GeekOmar256/SmartSplint/docs/flowcharts/block_diagram.png

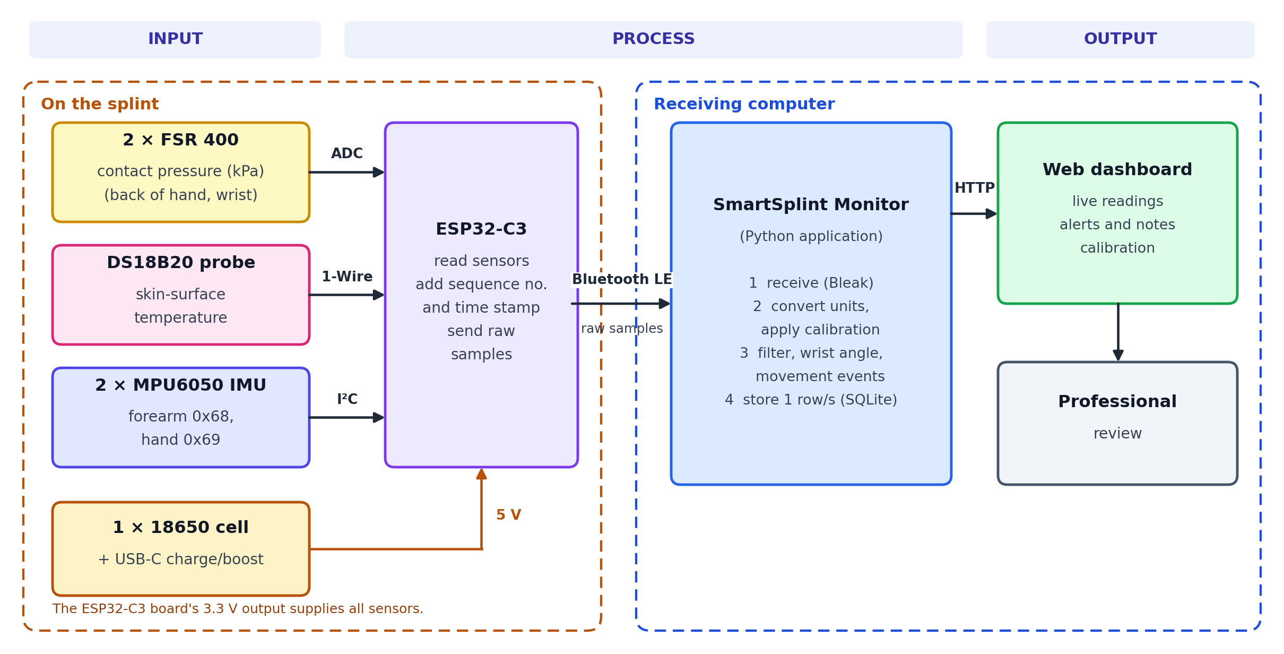
docs/flowcharts/block_diagram.png
