GeekOmar256/SmartSplint/docs/SmartSplint System Architecture.png

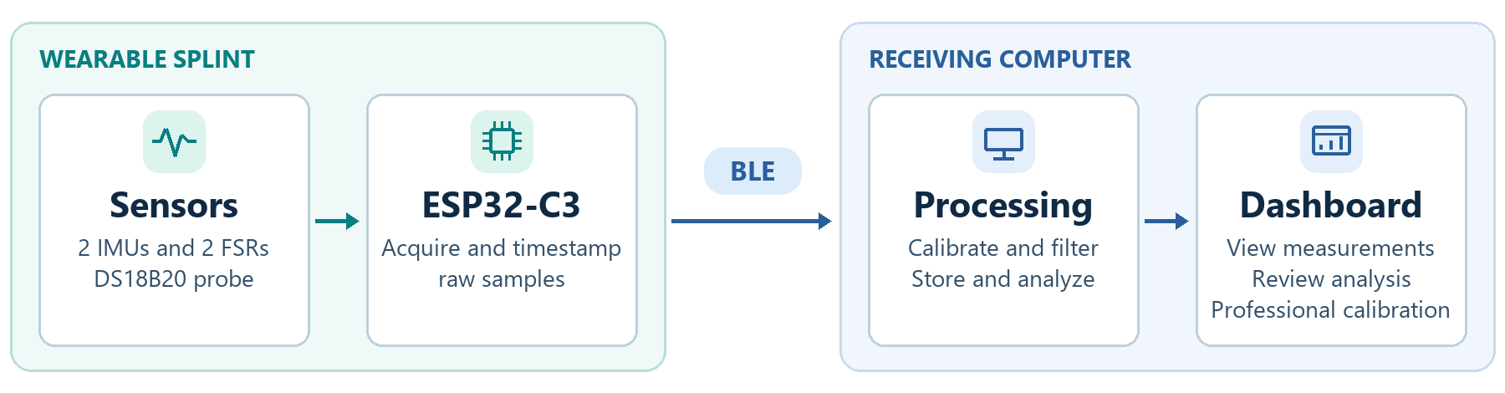
docs/SmartSplint System Architecture.png
