GeekOmar256/SmartSplint/SETUP_COMMANDS.txt

==========================================================================================
 Smart Orthopedic Splint - تثبيت البرنامج على كمبيوتر جديد (Windows 10 / 11)
==========================================================================================
 نفّذ الأوامر بالترتيب في PowerShell.
 (افتح قائمة Start، اكتب PowerShell، ثم اضغط Enter)
 انسخ كل أمر كما هو، ثم اضغط Enter بعده.

------------------------------------------------------------------------------------------
 الخطوة 1: تثبيت Python 3.12 (مع إضافته إلى الـ PATH)
------------------------------------------------------------------------------------------
winget install --id Python.Python.3.12 -e --override "/quiet InstallAllUsers=0 PrependPath=1 Include_launcher=1"

------------------------------------------------------------------------------------------
 الخطوة 2: تثبيت Git
------------------------------------------------------------------------------------------
winget install --id Git.Git -e

------------------------------------------------------------------------------------------
 الخطوة 3: أغلق نافذة PowerShell وافتح نافذة جديدة
------------------------------------------------------------------------------------------
 هذا ضروري حتى تتعرف النافذة الجديدة على python وgit.
 للتأكد من التثبيت، كل أمر من الأمرين التاليين يجب أن يطبع رقم إصدار:

python --version
git --version

------------------------------------------------------------------------------------------
 الخطوة 4: تنزيل الكود من GitHub
------------------------------------------------------------------------------------------
 المستودع عام (public)، لذلك لا يحتاج تسجيل دخول.

cd $HOME\Documents
git clone https://github.com/GeekOmar256/SmartSplint.git
cd SmartSplint

------------------------------------------------------------------------------------------
 الخطوة 5: تثبيت المكتبات
------------------------------------------------------------------------------------------
python -m pip install --upgrade pip
python -m pip install -r requirements.txt

 (اختياري) لإعادة رسم المخططات (flowcharts) ومخطط التوصيل:
python -m pip install -r requirements-docs.txt

------------------------------------------------------------------------------------------
 الخطوة 6: تشغيل التطبيق
------------------------------------------------------------------------------------------
 للتجربة بدون الجبيرة (بيانات محاكاة):
cd SmartSplint_Monitor
python server.py --simulate --demo-days 3

 مع الجبيرة الحقيقية (Bluetooth هو الاتصال الافتراضي):
python server.py

 تفتح الـ dashboard تلقائيًا على http://localhost:8000
 لإيقاف التطبيق اضغط Ctrl + C.
 يمكن أيضًا التشغيل بالضغط مرتين على run.bat أو run_simulation.bat داخل المجلد SmartSplint_Monitor.
 ملاحظة: شغّل Bluetooth في الكمبيوتر من Settings ثم Bluetooth & devices.

------------------------------------------------------------------------------------------
 الخطوة 7 (لرفع الكود على الـ ESP32): تثبيت Arduino IDE
------------------------------------------------------------------------------------------
winget install --id ArduinoSA.IDE.stable -e

 ثم داخل Arduino IDE:
   1) File > Preferences > Additional boards manager URLs، والصق هذا الرابط:
      https://espressif.github.io/arduino-esp32/package_esp32_index.json
   2) Tools > Board > Boards Manager: ابحث عن esp32 (by Espressif) وثبّت الإصدار 2.0.17
   3) Tools > Manage Libraries: ثبّت OneWire ثم DallasTemperature
   4) افتح الملف firmware\SmartSplint_Monitor_BLEOnly\SmartSplint_Monitor_BLEOnly.ino
   5) الإعدادات:
        Board            : ESP32C3 Dev Module
        USB CDC On Boot  : Enabled
        Partition Scheme : Default
   6) اختر الـ Port، ثم اضغط Upload

------------------------------------------------------------------------------------------
 (بديل للخطوة 7) رفع الكود باستخدام سطر الأوامر arduino-cli
------------------------------------------------------------------------------------------
winget install --id ArduinoSA.CLI -e
 (أغلق PowerShell وافتح نافذة جديدة، ثم ادخل مجلد SmartSplint مرة أخرى)
arduino-cli config init
arduino-cli config add board_manager.additional_urls https://espressif.github.io/arduino-esp32/package_esp32_index.json
arduino-cli core update-index
arduino-cli core install esp32:esp32@2.0.17
arduino-cli lib install OneWire DallasTemperature
arduino-cli board list
 (اكتب رقم الـ Port الظاهر، مثل COM5، بدل COM5 في الأمر التالي)
arduino-cli compile --upload -p COM5 --fqbn "esp32:esp32:esp32c3:CDCOnBoot=cdc" firmware\SmartSplint_Monitor_BLEOnly

------------------------------------------------------------------------------------------
 تحديث الكود لاحقًا (بعد أي تعديل جديد على GitHub)
------------------------------------------------------------------------------------------
cd $HOME\Documents\SmartSplint
git pull
python -m pip install -r requirements.txt
