GeekOmar256/SmartSplint/docs/flowcharts/wiring_diagram.png

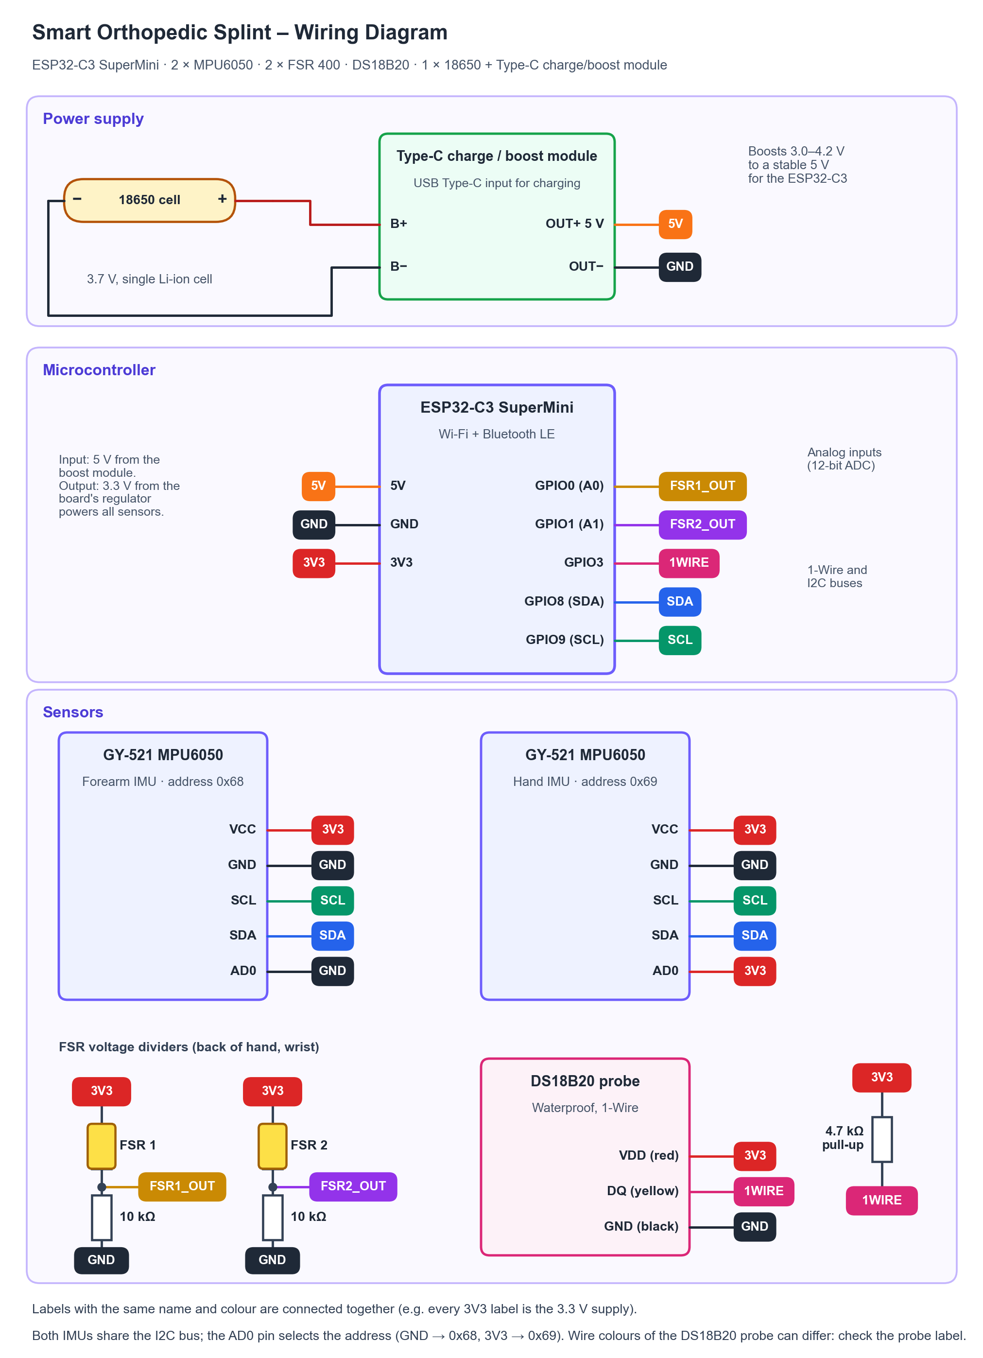
docs/flowcharts/wiring_diagram.png
