GeekOmar256/SmartSplint/firmware/SmartSplint_HardwareTest/wiring-diagram-connected.png

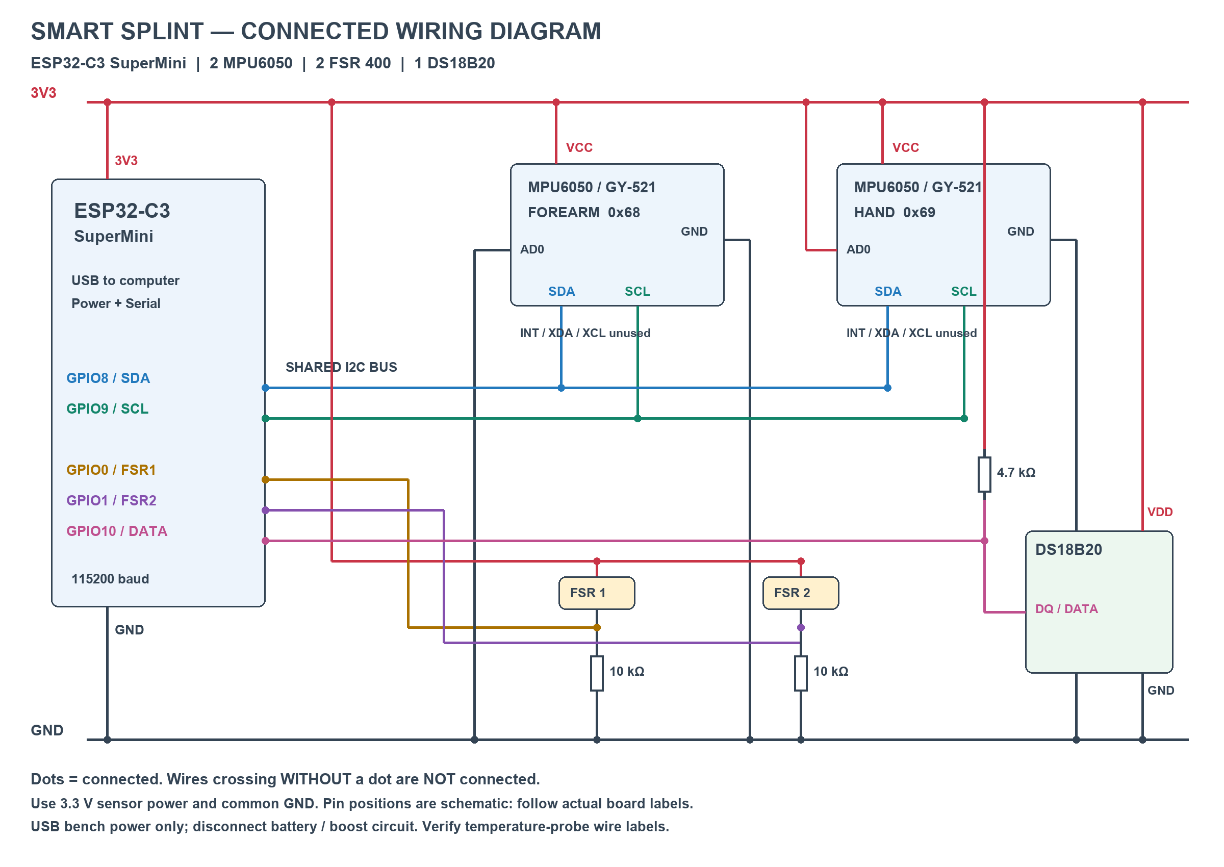
firmware/SmartSplint_HardwareTest/wiring-diagram-connected.png
