GeekOmar256/SmartSplint/firmware/SmartSplint_HardwareTest/wiring-diagram.png

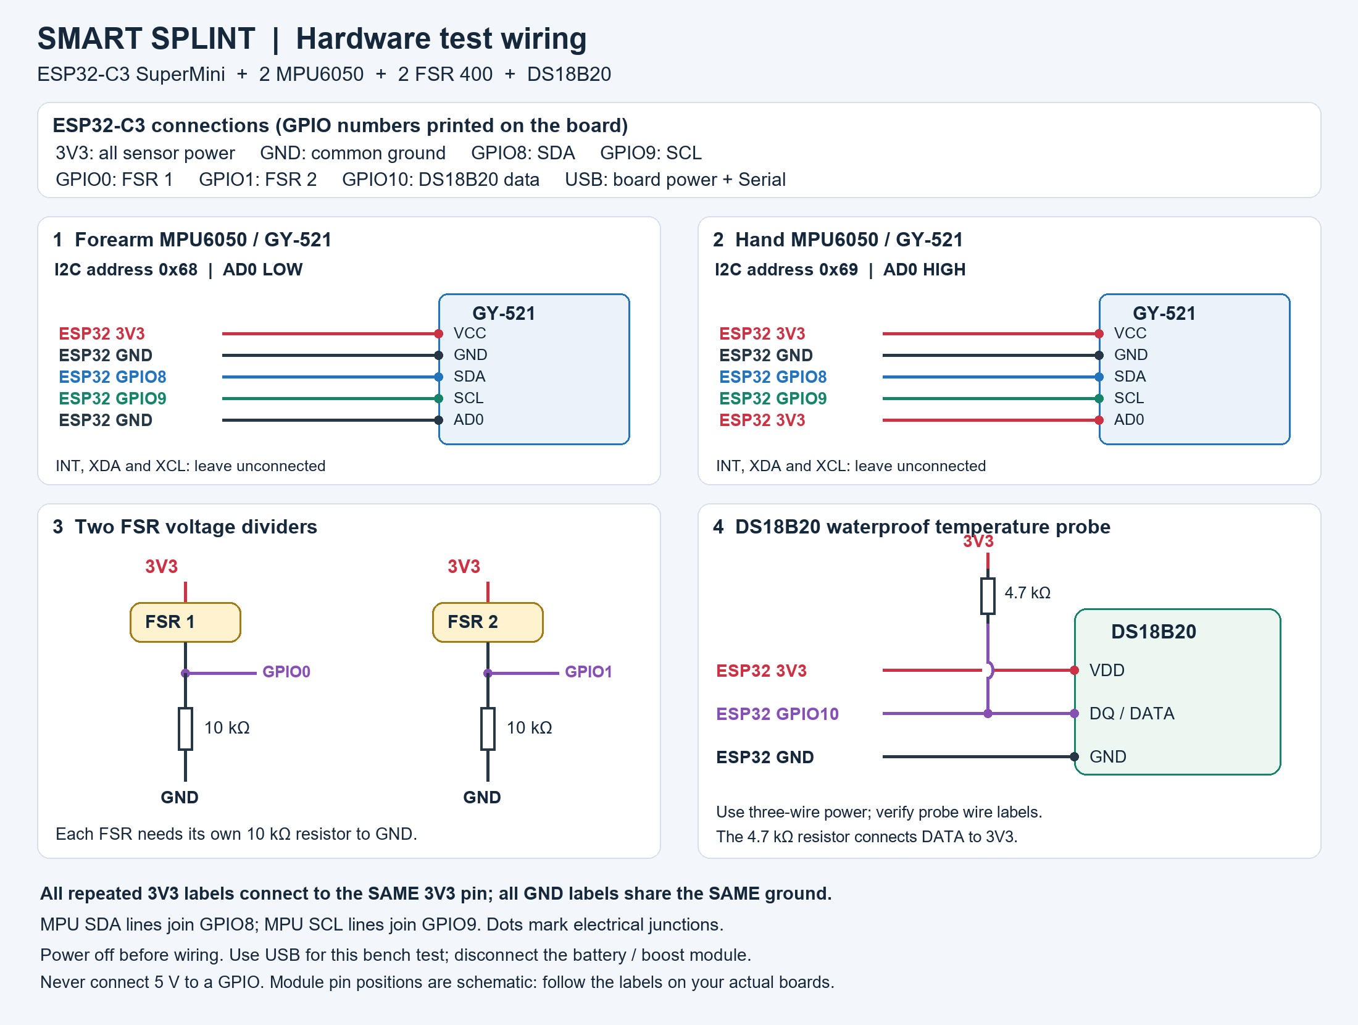
firmware/SmartSplint_HardwareTest/wiring-diagram.png
