GeekOmar256/SmartSplint/firmware/SmartSplint_HardwareTest/wiring-fritzing-style.png

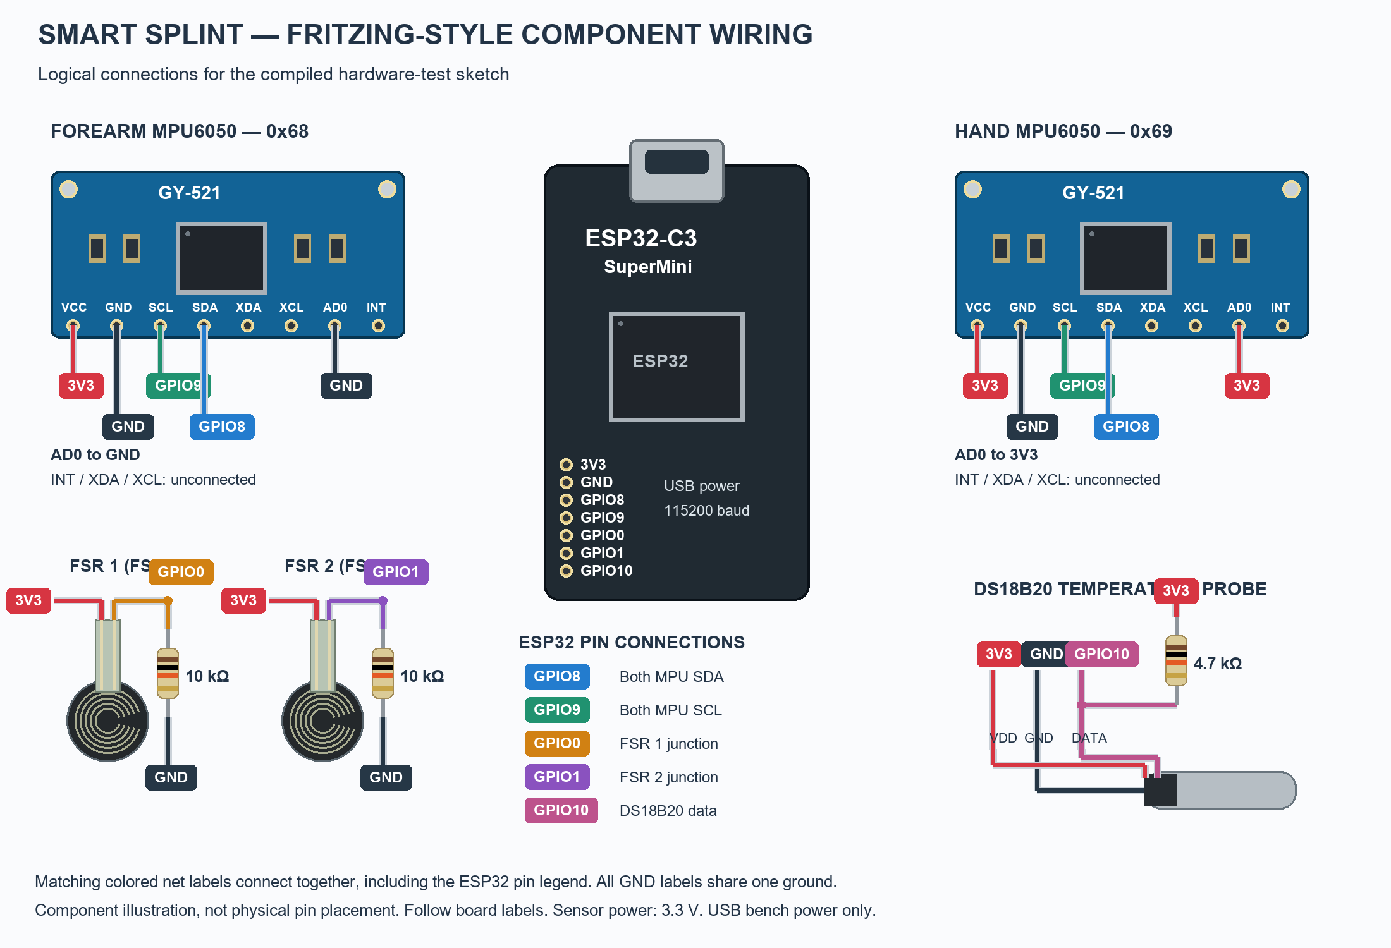
firmware/SmartSplint_HardwareTest/wiring-fritzing-style.png
