GeekOmar256/SmartSplint/(commit log)

2026-11-07 Pin bleak to the tested 2.x series
2026-11-07 Align BLE IMU settings with working reference and add diagnostics
2026-11-14 Pressure in kPa, simpler dashboard, BLE-only docs and updated diagrams
    - App: FSR readings reported as contact pressure in kPa (force / FSR 400 active
    area); old databases with N columns are converted on start
    - Dashboard: Analysis page, Notes card and bottom Alerts card removed; Alerts
    panel appears only when an alert occurs; cards arranged in a 3 x 2 grid;
    calibration behind a password
    - Flowcharts redrawn without simulation branches; new block diagram;
    wiring diagram for one 18650 cell
    - README, setup steps and code documentation updated
